1797yuuu17/FPGA/docs/hardware/audio_adapter_perfboard.png

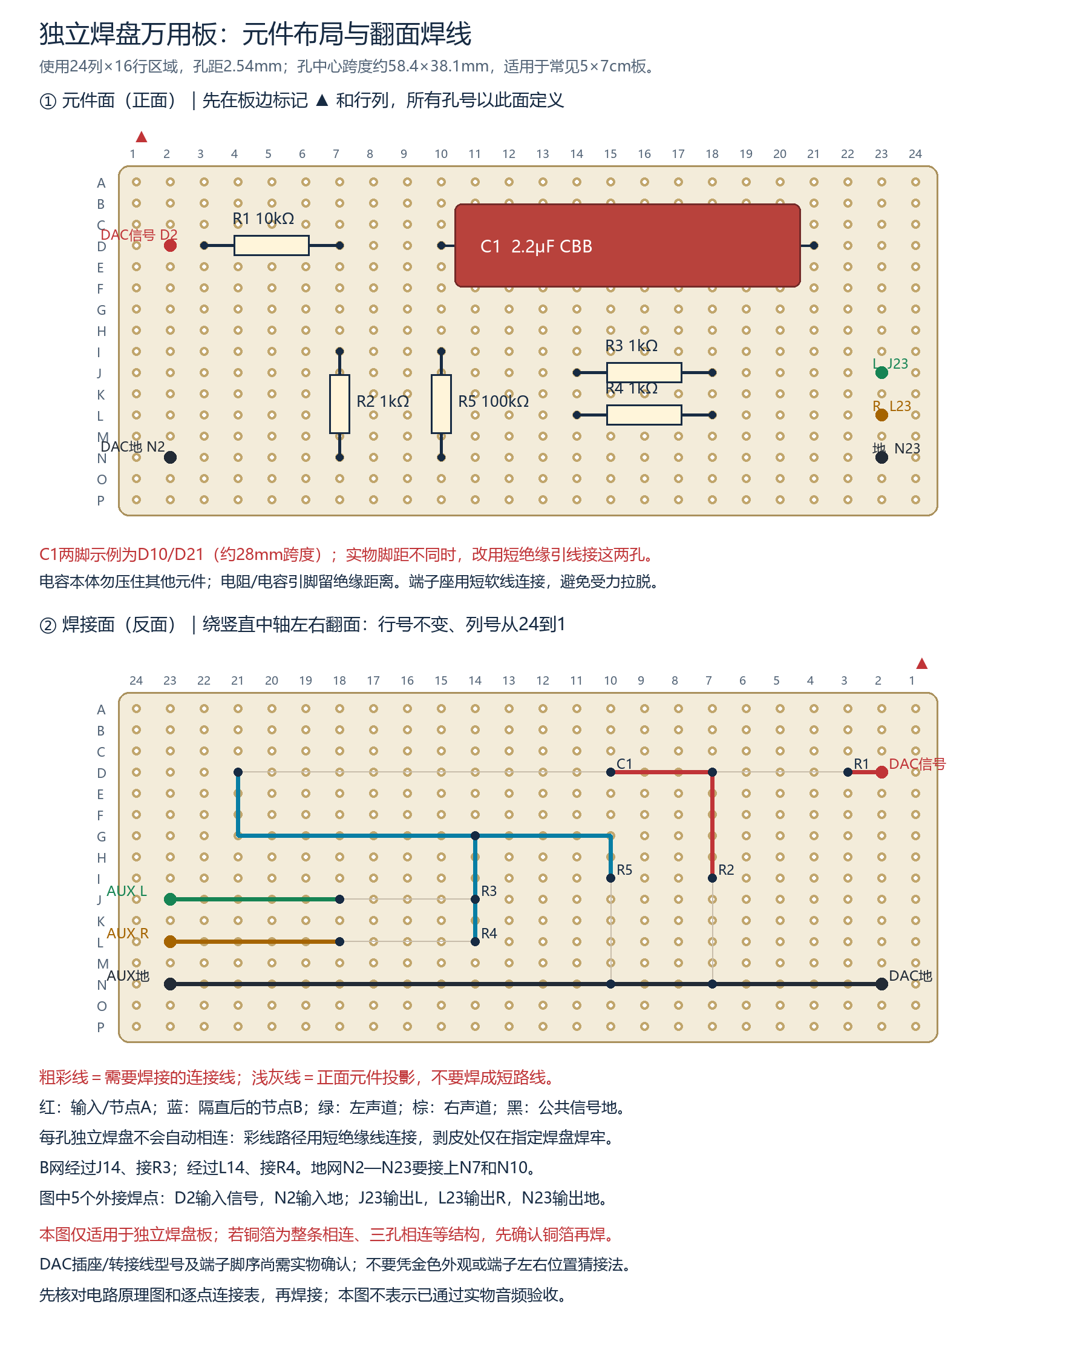
docs/hardware/audio_adapter_perfboard.png
