1797yuuu17/FPGA/docs/hardware/audio_adapter_schematic.png

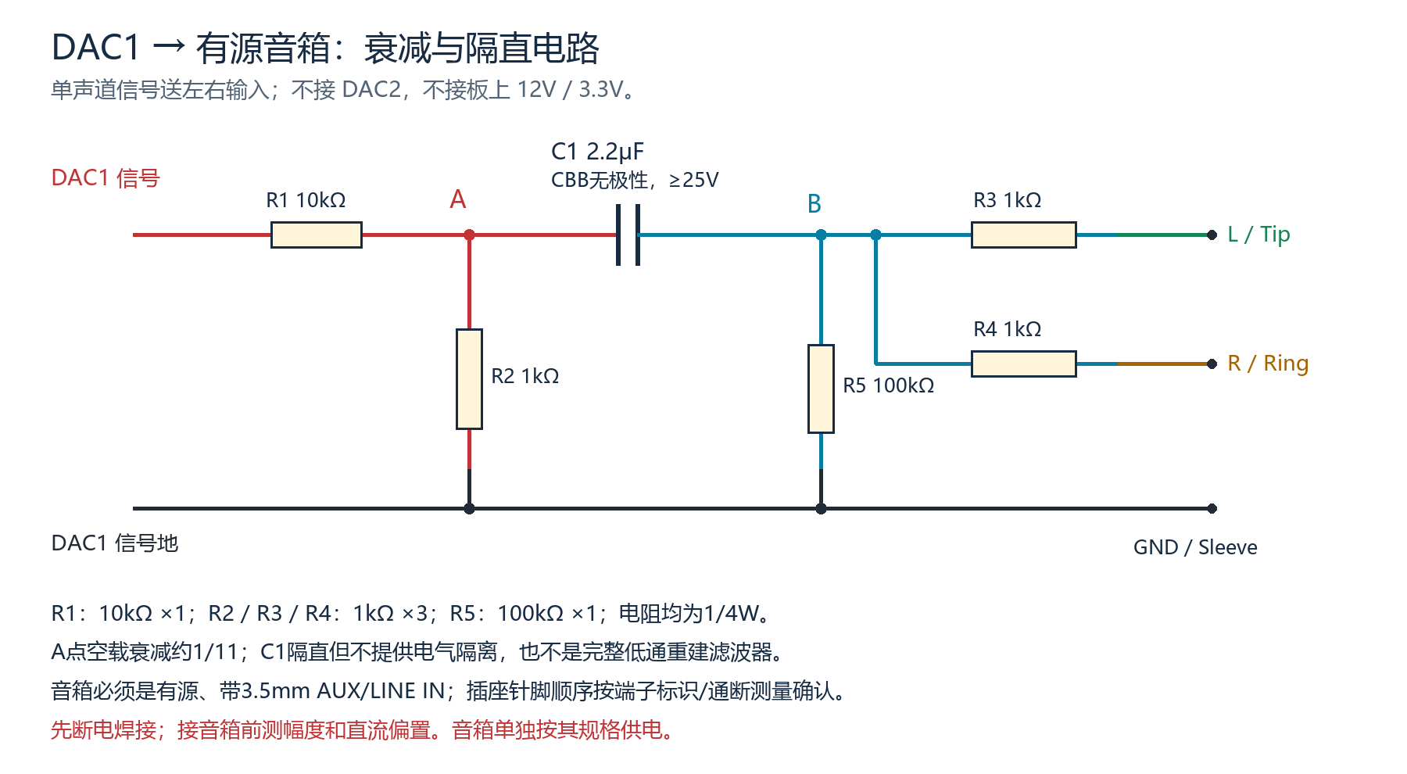
docs/hardware/audio_adapter_schematic.png
