1797yuuu17/FPGA/docs/VERIFICATION.md

# 验证范围

发布基线：2026-11-03双输出版。FPGA源代码保持实测版本；公开版仅将播放器启动和ModelSim脚本改成可配置路径，并在播放器启动时创建运行日志目录。

- 5项ModelSim测试通过：双输出逐周期与原DAC/USB比较、录放、片段保护、小星星、120秒/2048事件相关边界。
- 仿真UART的384个音频样本经Python逐样本核对一致。
- Gowin50MHz约束setup/hold违例0，Fmax50.755MHz，逻辑3045/8640，BSRAM10/26。
- 实物SRAM Program and Verify通过。原始基线码流SHA256：`ade329a3d2558b9083979fe19d6fa3f8b2603a3dbd53937bdcc96b18c64d1218`。不同工具/实现配置重建的码流可能不同。
- 30秒串口2929帧及重新打开5秒488帧，无CRC或序号错误；这两次为静音传输检查。
- 用户已确认两端同时发声，以及停止电脑播放器后DAC仍可演奏。
- 未完成完整功能逐项实物回归、长时耐久、声学延迟、失真及信噪比测量；不声称双路声学同步。

本仓库不含EDA工具、授权文件、本机运行日志或预编译码流。请使用Gowin从源代码构建。

2026-11-04 发布整理后，在公开版目录重新运行五项 ModelSim 仿真全部通过，UART 384 个样本比较一致、CRC 错误为零；11 项 Python 单元测试通过。ModelSim 有测试台未连接部分未观测输出端口的警告，未出现 Error 或 Fatal。Python 测试复用了开发机已安装依赖，未执行全新环境联网安装测试。
