1797yuuu17/FPGA/src/waveform.v

// Generated sine table; square and triangle are computed without multipliers.
module waveform(input [31:0] phase,input [1:0] shape,output reg signed [15:0] value);
reg signed [15:0] sine;
wire [15:0] ramp=phase[31]?~phase[30:15]:phase[30:15];
always @* begin
case(phase[31:24])
8'd0: sine=16'h0000;
8'd1: sine=16'h02e0;
8'd2: sine=16'h05c0;
8'd3: sine=16'h089f;
8'd4: sine=16'h0b7d;
8'd5: sine=16'h0e58;
8'd6: sine=16'h1132;
8'd7: sine=16'h1409;
8'd8: sine=16'h16dd;
8'd9: sine=16'h19ad;
8'd10: sine=16'h1c79;
8'd11: sine=16'h1f41;
8'd12: sine=16'h2205;
8'd13: sine=16'h24c2;
8'd14: sine=16'h277b;
8'd15: sine=16'h2a2d;
8'd16: sine=16'h2cd9;
8'd17: sine=16'h2f7d;
8'd18: sine=16'h321b;
8'd19: sine=16'h34b0;
8'd20: sine=16'h373e;
8'd21: sine=16'h39c3;
8'd22: sine=16'h3c3f;
8'd23: sine=16'h3eb2;
8'd24: sine=16'h411b;
8'd25: sine=16'h437a;
8'd26: sine=16'h45cf;
8'd27: sine=16'h4819;
8'd28: sine=16'h4a58;
8'd29: sine=16'h4c8b;
8'd30: sine=16'h4eb3;
8'd31: sine=16'h50ce;
8'd32: sine=16'h52dd;
8'd33: sine=16'h54df;
8'd34: sine=16'h56d5;
8'd35: sine=16'h58bc;
8'd36: sine=16'h5a96;
8'd37: sine=16'h5c62;
8'd38: sine=16'h5e20;
8'd39: sine=16'h5fd0;
8'd40: sine=16'h6170;
8'd41: sine=16'h6302;
8'd42: sine=16'h6484;
8'd43: sine=16'h65f7;
8'd44: sine=16'h675a;
8'd45: sine=16'h68ad;
8'd46: sine=16'h69f0;
8'd47: sine=16'h6b22;
8'd48: sine=16'h6c44;
8'd49: sine=16'h6d56;
8'd50: sine=16'h6e56;
8'd51: sine=16'h6f46;
8'd52: sine=16'h7024;
8'd53: sine=16'h70f1;
8'd54: sine=16'h71ad;
8'd55: sine=16'h7257;
8'd56: sine=16'h72f0;
8'd57: sine=16'h7376;
8'd58: sine=16'h73eb;
8'd59: sine=16'h744e;
8'd60: sine=16'h74a0;
8'd61: sine=16'h74df;
8'd62: sine=16'h750c;
8'd63: sine=16'h7527;
8'd64: sine=16'h7530;
8'd65: sine=16'h7527;
8'd66: sine=16'h750c;
8'd67: sine=16'h74df;
8'd68: sine=16'h74a0;
8'd69: sine=16'h744e;
8'd70: sine=16'h73eb;
8'd71: sine=16'h7376;
8'd72: sine=16'h72f0;
8'd73: sine=16'h7257;
8'd74: sine=16'h71ad;
8'd75: sine=16'h70f1;
8'd76: sine=16'h7024;
8'd77: sine=16'h6f46;
8'd78: sine=16'h6e56;
8'd79: sine=16'h6d56;
8'd80: sine=16'h6c44;
8'd81: sine=16'h6b22;
8'd82: sine=16'h69f0;
8'd83: sine=16'h68ad;
8'd84: sine=16'h675a;
8'd85: sine=16'h65f7;
8'd86: sine=16'h6484;
8'd87: sine=16'h6302;
8'd88: sine=16'h6170;
8'd89: sine=16'h5fd0;
8'd90: sine=16'h5e20;
8'd91: sine=16'h5c62;
8'd92: sine=16'h5a96;
8'd93: sine=16'h58bc;
8'd94: sine=16'h56d5;
8'd95: sine=16'h54df;
8'd96: sine=16'h52dd;
8'd97: sine=16'h50ce;
8'd98: sine=16'h4eb3;
8'd99: sine=16'h4c8b;
8'd100: sine=16'h4a58;
8'd101: sine=16'h4819;
8'd102: sine=16'h45cf;
8'd103: sine=16'h437a;
8'd104: sine=16'h411b;
8'd105: sine=16'h3eb2;
8'd106: sine=16'h3c3f;
8'd107: sine=16'h39c3;
8'd108: sine=16'h373e;
8'd109: sine=16'h34b0;
8'd110: sine=16'h321b;
8'd111: sine=16'h2f7d;
8'd112: sine=16'h2cd9;
8'd113: sine=16'h2a2d;
8'd114: sine=16'h277b;
8'd115: sine=16'h24c2;
8'd116: sine=16'h2205;
8'd117: sine=16'h1f41;
8'd118: sine=16'h1c79;
8'd119: sine=16'h19ad;
8'd120: sine=16'h16dd;
8'd121: sine=16'h1409;
8'd122: sine=16'h1132;
8'd123: sine=16'h0e58;
8'd124: sine=16'h0b7d;
8'd125: sine=16'h089f;
8'd126: sine=16'h05c0;
8'd127: sine=16'h02e0;
8'd128: sine=16'h0000;
8'd129: sine=16'hfd20;
8'd130: sine=16'hfa40;
8'd131: sine=16'hf761;
8'd132: sine=16'hf483;
8'd133: sine=16'hf1a8;
8'd134: sine=16'heece;
8'd135: sine=16'hebf7;
8'd136: sine=16'he923;
8'd137: sine=16'he653;
8'd138: sine=16'he387;
8'd139: sine=16'he0bf;
8'd140: sine=16'hddfb;
8'd141: sine=16'hdb3e;
8'd142: sine=16'hd885;
8'd143: sine=16'hd5d3;
8'd144: sine=16'hd327;
8'd145: sine=16'hd083;
8'd146: sine=16'hcde5;
8'd147: sine=16'hcb50;
8'd148: sine=16'hc8c2;
8'd149: sine=16'hc63d;
8'd150: sine=16'hc3c1;
8'd151: sine=16'hc14e;
8'd152: sine=16'hbee5;
8'd153: sine=16'hbc86;
8'd154: sine=16'hba31;
8'd155: sine=16'hb7e7;
8'd156: sine=16'hb5a8;
8'd157: sine=16'hb375;
8'd158: sine=16'hb14d;
8'd159: sine=16'haf32;
8'd160: sine=16'had23;
8'd161: sine=16'hab21;
8'd162: sine=16'ha92b;
8'd163: sine=16'ha744;
8'd164: sine=16'ha56a;
8'd165: sine=16'ha39e;
8'd166: sine=16'ha1e0;
8'd167: sine=16'ha030;
8'd168: sine=16'h9e90;
8'd169: sine=16'h9cfe;
8'd170: sine=16'h9b7c;
8'd171: sine=16'h9a09;
8'd172: sine=16'h98a6;
8'd173: sine=16'h9753;
8'd174: sine=16'h9610;
8'd175: sine=16'h94de;
8'd176: sine=16'h93bc;
8'd177: sine=16'h92aa;
8'd178: sine=16'h91aa;
8'd179: sine=16'h90ba;
8'd180: sine=16'h8fdc;
8'd181: sine=16'h8f0f;
8'd182: sine=16'h8e53;
8'd183: sine=16'h8da9;
8'd184: sine=16'h8d10;
8'd185: sine=16'h8c8a;
8'd186: sine=16'h8c15;
8'd187: sine=16'h8bb2;
8'd188: sine=16'h8b60;
8'd189: sine=16'h8b21;
8'd190: sine=16'h8af4;
8'd191: sine=16'h8ad9;
8'd192: sine=16'h8ad0;
8'd193: sine=16'h8ad9;
8'd194: sine=16'h8af4;
8'd195: sine=16'h8b21;
8'd196: sine=16'h8b60;
8'd197: sine=16'h8bb2;
8'd198: sine=16'h8c15;
8'd199: sine=16'h8c8a;
8'd200: sine=16'h8d10;
8'd201: sine=16'h8da9;
8'd202: sine=16'h8e53;
8'd203: sine=16'h8f0f;
8'd204: sine=16'h8fdc;
8'd205: sine=16'h90ba;
8'd206: sine=16'h91aa;
8'd207: sine=16'h92aa;
8'd208: sine=16'h93bc;
8'd209: sine=16'h94de;
8'd210: sine=16'h9610;
8'd211: sine=16'h9753;
8'd212: sine=16'h98a6;
8'd213: sine=16'h9a09;
8'd214: sine=16'h9b7c;
8'd215: sine=16'h9cfe;
8'd216: sine=16'h9e90;
8'd217: sine=16'ha030;
8'd218: sine=16'ha1e0;
8'd219: sine=16'ha39e;
8'd220: sine=16'ha56a;
8'd221: sine=16'ha744;
8'd222: sine=16'ha92b;
8'd223: sine=16'hab21;
8'd224: sine=16'had23;
8'd225: sine=16'haf32;
8'd226: sine=16'hb14d;
8'd227: sine=16'hb375;
8'd228: sine=16'hb5a8;
8'd229: sine=16'hb7e7;
8'd230: sine=16'hba31;
8'd231: sine=16'hbc86;
8'd232: sine=16'hbee5;
8'd233: sine=16'hc14e;
8'd234: sine=16'hc3c1;
8'd235: sine=16'hc63d;
8'd236: sine=16'hc8c2;
8'd237: sine=16'hcb50;
8'd238: sine=16'hcde5;
8'd239: sine=16'hd083;
8'd240: sine=16'hd327;
8'd241: sine=16'hd5d3;
8'd242: sine=16'hd885;
8'd243: sine=16'hdb3e;
8'd244: sine=16'hddfb;
8'd245: sine=16'he0bf;
8'd246: sine=16'he387;
8'd247: sine=16'he653;
8'd248: sine=16'he923;
8'd249: sine=16'hebf7;
8'd250: sine=16'heece;
8'd251: sine=16'hf1a8;
8'd252: sine=16'hf483;
8'd253: sine=16'hf761;
8'd254: sine=16'hfa40;
8'd255: sine=16'hfd20;
endcase
case(shape)
0:value=sine;
1:value=phase[31]?-16'sd30000:16'sd30000;
2:value=$signed(ramp^16'h8000);
default:value=sine;
endcase
end
endmodule
